alex2eva/autonomous-rc-car/autonomous-rc-car.docx

МИНИСТЕРСТКО ЦИФРОВОГО РАЗВИТИЯ СВЯЗИ И МАССОВЫХ

КОММУНИКАЦИЙ РОССИЙСКОЙ ФЕДЕРАЦИИ

Ордена трудового красного знамени федеральное государственное бюджетное

образовательное учреждение высшего образования

«Московский технический университет связи и информатики»

Факультет «Кибернетики и информационной безопасности»

Кафедра «Интеллектуальные системы в управлении и автоматизации»

КУРСОВАЯ РАБОТА

По дисциплине «Киберфизические системы и интернет вещей»

на тему «Создание прототипа движущегося робота, управляемого с помощью фоточувствительных элементов»

Выполнил:

студент 1 курса

группы БУТ2301

Алексеева Екатерина Вячеславовна

Приняла:

д.ф.-м.н., проф. Воронова Л. И.

Москва 2024

Введение

Развитие робототехники в последние десятилетия приобретает все более стремительный характер. Роботы все чаще применяются в различных сферах человеческой деятельности: от промышленного производства до оказания помощи в быту. Одним из ключевых направлений развития робототехники является создание автономных роботов, способных к самостоятельному передвижению и выполнению задач в сложных и динамичных средах.

Автономные движущиеся платформы востребованы в таких областях как: складская логистика, доставка товаров и грузов, транспорт, выполнение работ в труднодоступных местах и агрессивных средах и многих других.

Важное значение при создании автономных движущихся платформ имеют алгоритмы управления, обеспечивающие способность устройств эффективно и безопасно двигаться по требуемым маршрутам, а также их надежность и расширяемость.

В рамках данного проекта будет разработан функциональный прототип робота-машины, управляемого с помощью фоточувствительных элементов, демонстрирующий возможность автономного передвижения, основанного на обработке визуальной информации.

В ходе работы над проектом должны быть выполнены следующие задачи:

1. Провести анализ современных технологий и алгоритмов управления движущимися устройствами.
2. Определить набор функциональных требований к прототипу.
3. Выполнить проектирование аппаратной части прототипа, провести подбор элементной базы, реализовать размещение и подключение элементов.
4. Разработать программное обеспечение для реализации алгоритмов управления прототипом.
5. Провести испытания прототипа на предмет соответствия предъявляемым требованиям.

## 1. Анализ современных технологий и алгоритмов управления устройствами

По принципу управления автономные движущиеся платформы разделяют на полностью автономные и дистанционно управляемые. К первому типу относят системы, которые определяют параметры движения (направление, скорость) без внешних управляющих сигналов. Параметры движения систем второго типа корректируются с помощью внешних управляющих сигналов. Для ряда задач используют движущиеся платформы комбинированного типа.

Независимо от наличия или отсутствия внешних управляющих сигналов, движения систем по заданному маршруту обеспечивается реализованными в блоке управления системы алгоритмами. На рисунке «Рисунок 1» изображен пример движущегося устройства - Робот мобильного видеонаблюдения и охраны «Трал Патруль 4.0» [1].

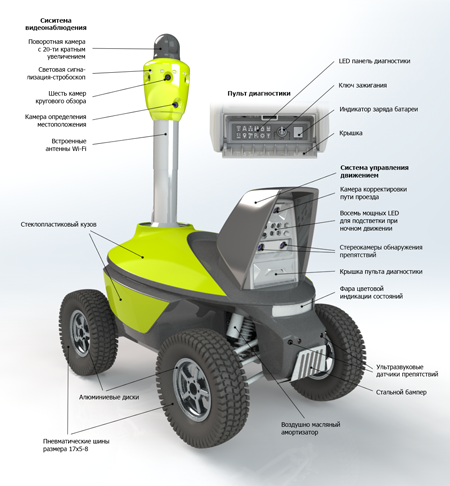
[picture p1: figure]

Рисунок 1 - Робот мобильного видеонаблюдения и охраны «Трал Патруль 4.0»

## 1.1 Технологии и механизмы управления движущимися устройствами

Для обеспечения движения полностью автономной платформы по заданному маршруту могут использоваться следующие технологии:

- Визуальное управление, на базе систем технического зрения [2].
- Управление на базе системы геопозиционирования [3].
- Следование заложенной в память устройства карте маршрута.

Для определения всех или отдельных параметров движения системы, управляемой с помощью внешних сигналов, возможны следующие способы:

- Передача управляющих сигналов посредством радиоканала, через сетевую инфраструктуру (мобильные сети, Wi-Fi и др.), проводное управление [4].
- Прокладывание трассы для передвижения (рельсы, магнитная лента).
- Следование за лидером.

Также для обеспечения заданных параметров движения применяются следующие датчики [5]:

- Ультразвуковые датчики расстояния.
- Датчики пространственного положения.
- Датчики скорости и ускорения.
- Фоточувствительные элементы.

## 1.2 Определяющие факторы при выборе способов управления

При проектировании автономной движущейся системы выбор способов управления необходимо осуществлять исходя из предъявляемых требований и стоимости реализации. В частности, нужно принимать во внимание следующие аспекты:

- Вариативность маршрутов.
- Динамичность изменения окружения.
- Технические ограничения возможности передачи управляющих сигналов.
- Требуемая точность соблюдения заданных параметров движения.

## 1.3 Постановка функциональных требований

В рамках проекта необходимо спроектировать и реализовать прототип движущегося робота, отвечающий следующим требованиям:

- Работа алгоритма робота должна начинаться и прекращаться по команде с ИК пульта управления.
- Направление движения робота должно определяться величиной светового потока на двух фоторезисторах.
- Должен быть реализован механизм предотвращения столкновения с препятствиями.

## Выводы

В данном разделе проанализированы современные технологии и алгоритмы управления движущимися устройствами, сформулированы требования к разрабатываемому в рамках проекта прототипа.

## 2. Разработка аппаратной части, проектирование

## 2.1 Архитектура и принцип работы разрабатываемого макета

В рамках проекта для управления самодвижущейся платформой использованы следующие способы управления (табл. 1):

Таблица 1 – Возможные способы управления платформой

Параметр движения | Тип управления | Механизм управления
Задание направления движения | Внешний сигнал | Фоточувствительные элементы
Задание скорости движения | Не осуществляется
Предотвращение столкновений | Внутренний датчик | Ультразвуковой датчик расстояния
Включение и выключение питания | Внешний сигнал | Инфракрасный пульт управления

На рисунке «Рисунок 2» изображена схема собранного прототипа.

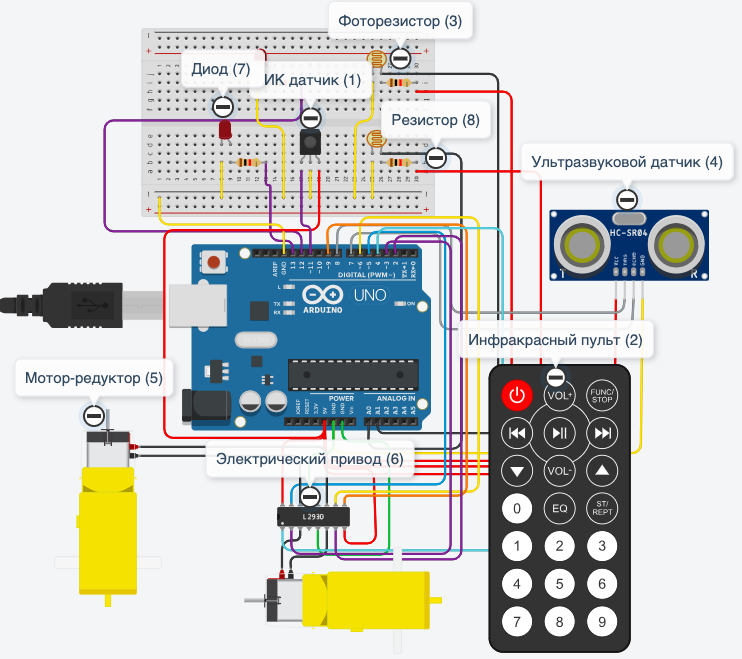
[picture p2: figure]

Рисунок 2 – Схема прототипа

## 2.2 Элементная база

Для реализации прототипа используется платформа Arduino Uno R3 (Рисунок 3).

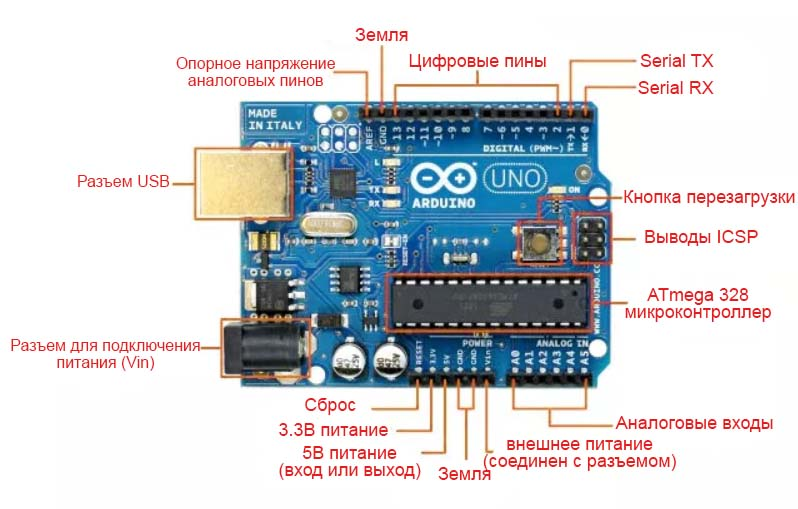
[picture p3: figure]
Arduino Uno R3. Распиновка, питание и подключение

Рисунок 3 - Расположение основных элементов на плате Arduino UNO R3

Для включения и выключения робота используется инфракрасный пульт управления (2) и ИК-датчик (1) [6].

Управление направлением движения робота осуществляется с помощью двух фоточувствительных элементов (ФЧЭ) следующим образом: в случае отсутствия светового потока на обоих ФЧЭ – робот не двигается, в случае наличия одинакового светового потока на обоих ФЧЭ – робот движется в прямом направлении, в случае если световой поток на одном из ФЧЭ интенсивнее - робот осуществляет поворот в сторону данного ФЧЭ. В качестве фоточувствительных элементов используется фоторезисторы MLG5516 (3) [7].

Для предотвращения столкновений используется ультразвуковой датчик HS-SR04 (4) (Рисунок 4) [8]. При достижении настраиваемой дистанции до препятствия робот останавливается.

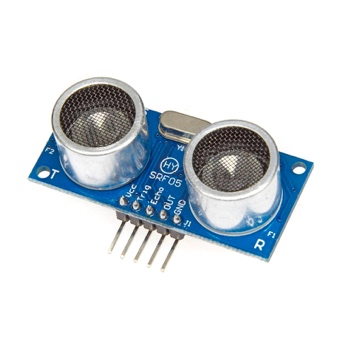
[picture p4: figure]
HY-SRF05 - купить в Москве ультразвуковой дальномер для Arduino с доставкой по России и СНГ

Рисунок 4 - Ультразвуковой датчик HS-SR04

Для передвижения используются 4 мотора-редуктора (5) [9], соединенные с колесами. Моторы редукторы подключаются через модуль управления двигателем L298N (Рисунок 5 и Рисунок 6) [10]. Изменение направления движения осуществляется путем обеспечения разницы скоростей вращения двигателей на левой и правой сторонах робота.

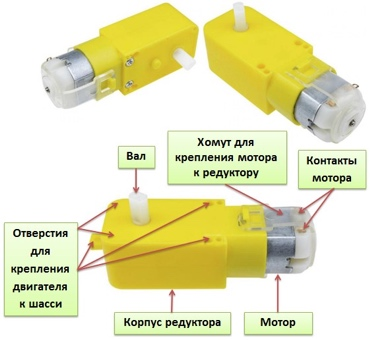
[picture p5: figure]
Мотор-редуктор 1:48
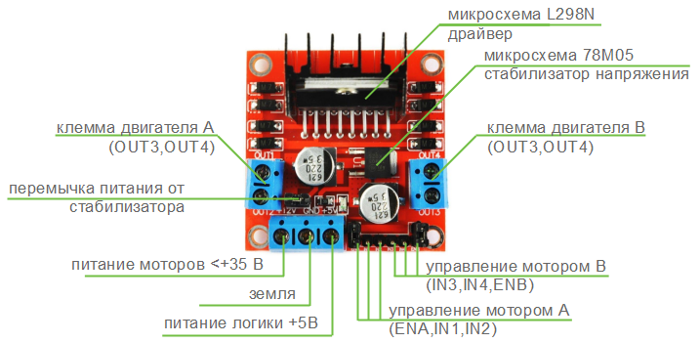
[picture p6: figure]
Драйвер мотора L298N элементы

Рисунок 5 - Мотор постоянного тока с редуктором | Рисунок 6 - Драйвер L298N для мотора постоянного тока

Для возможности осуществления визуального контроля за работой алгоритма робота используются два светодиода – индикатора направления движения (7).

Ниже приведена таблица элементов, необходимых для создания робота (табл. 2).

Таблица 2 – Перечень оборудования, необходимого для создания модели

№ п/п | Наименование оборудования | Цена, руб. | Кол-во, шт. | Сумма, руб.
1. | Плата Arduino UNO R3 | 890 | 1 | 890
2. | Макетная плата 830 точек | 160 | 1 | 160
3. | Соединительные провода | 2,5 | 31 | 77,5
4. | Светодиод | 12 | 2 | 24
5. | Резистор 220 Ом | 3 | 4 | 12
6. | Фоторезистор MLG5516 | 16 | 2 | 32
7. | ИК датчик VS1838B | 50 | 1 | 50
8. | Инфракрасный пульт | 189 | 1 | 189
9. | Ультразвуковой датчик HS-SR04 | 160 | 1 | 160
10. | Мотор-редуктор | 216 | 4 | 864
11. | Модуль управления двигателем L298N | 227 | 1 | 227
12. | Батареи | 39 | 3 | 117
13. | Батарейный отсек | 150 | 1 | 150
14. | Шасси | 325 | 2 | 650
15. | Колесо | 108 | 4 | 432
| ИТОГО | | | 4034

## 2.3 Сборка прототипа

Подключаем ИК датчик: левую ножку подключаем к цифровому выходу Arduino, правую – к питанию (5V), среднюю – к земле (GND).

Фоторезисторы подключаем через резисторы (8). Одной ножкой фоторезистор соединяется с землей (GND), другая подключается к выходу АЦП платы (аналого-цифровой преобразователь), к этой же ножке подключаем резистор 220 Ом.

Затем подключаем ультразвуковой датчик HS-SR04: контакт земли подключаем к выводу GND на плате Arduino, выход питания соединяем с 5V, выходы Trig и Echo подсоединяем к Arduino на цифровые выходы.

Светодиоды подключаем через резисторы. Короткой ножкой диод соединяется с землей (GND), другая подключается к цифровому выходу, к этой же ножке подключаем резистор 220 Ом.

Моторы-редукторы размещаются на шасси прототипа и подключаются к модулю управления двигателями L298N следующим образом:

- Контакты питания моторов подключаются к соответствующим выходам модуля управления (1 и 2 для левого, 3 и 4 для правого);
- Управляющие входы модуля управления (включение 1 и 2, включение 3 и 4) подключаются к цифровым выходам платы Arduino;
- Выходы питания модуля управления подключаются к 5V, выходы GND – к земле.

На схеме приведены два мотора-редуктора – этого достаточно для обеспечения принципиальной работоспособности схемы и алгоритмов.

Блок питания прототипа представлен тремя батареями 9V. Две из них, соединенные последовательно, питают модуль управления двигателями и через него - моторы-редукторы. Третья батарея питает плату Arduino.

## Выводы

В ходе данного раздела спроектирована монтажная схема, определены необходимые элементы и примерная стоимость модели, собран макет робота согласно монтажной схеме (Рисунок 7).

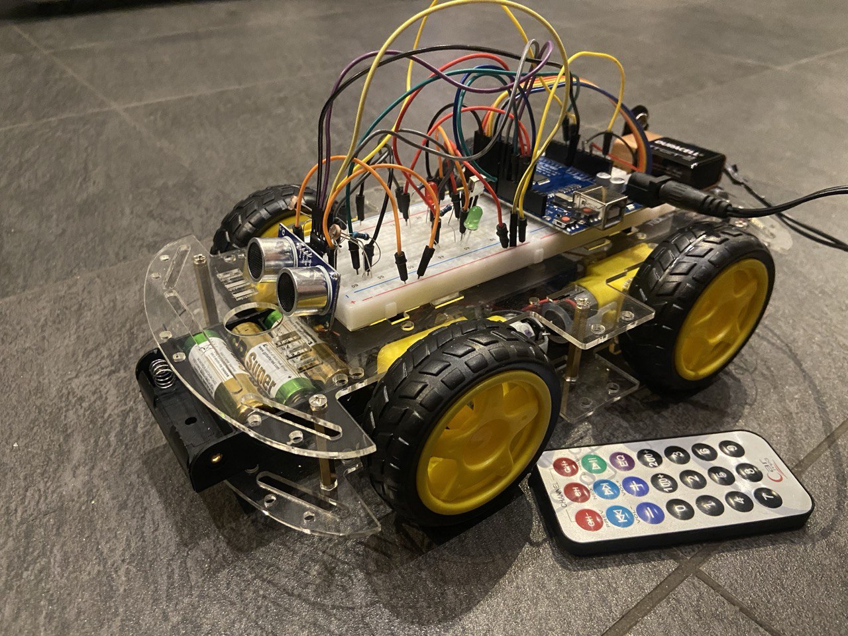
[picture p7: figure]

Рисунок 7 – Макет робота

## 3. Разработка программного обеспечения

## 3.1 Алгоритм управления прототипом

На рисунке «Рисунок 8» ниже представлен алгоритм управления прототипом.

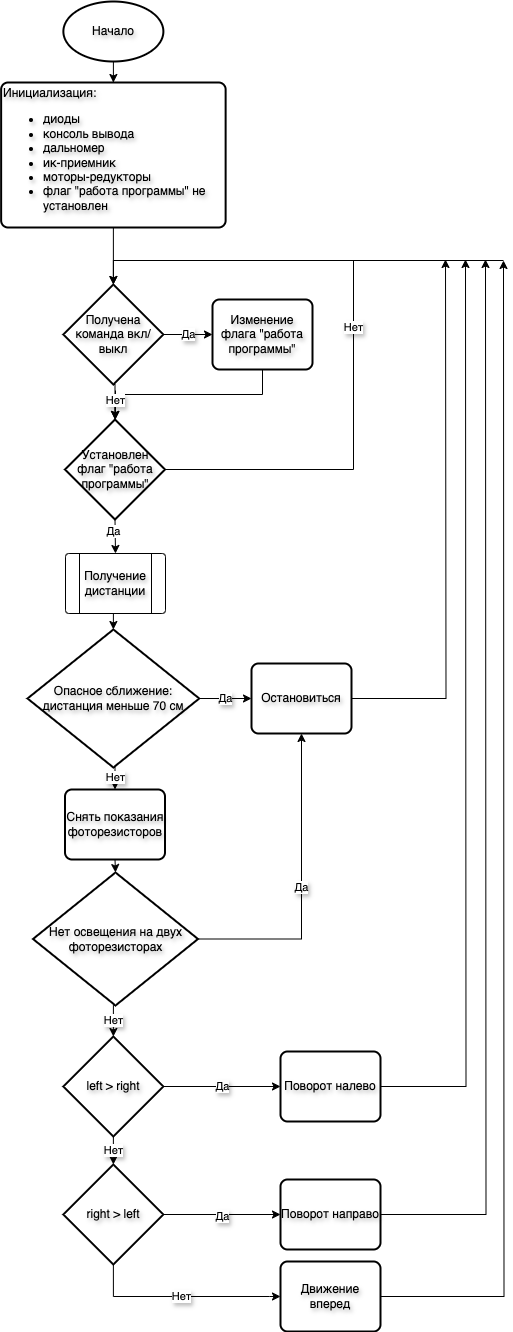
[picture p8: figure]

Рисунок 8 – Блок-схема алгоритма

## 3.2 Реализация программного обеспечения

Листинг 1 – подключение библиотек и определение констант и глобальных переменных, используемых в коде программы

В данном разделе производится инициализация переменных и определение констант. Детальная информация приведена в комментариях в коде.

//подключение библиотек

#include <IRremote.h>

//определение констант

//диоды

#define LED_LEFT 12

#define LED_RIGHT 13

//фоторезисторы

#define PS_LEFT A1

#define PS_RIGHT A0

#define PS_MAX 1017 // минимальное показание фоторезистора, означающее темноту

#define PS_MIN 350 // максимальное показание фоторезистора, означающее максимальную освещенность

#define PS_SENS 10 // минимальная разница между показаниями фоторезисторов для настройки чувствительности системы

//дальномер

#define PIN_TRIG 8

#define PIN_ECHO 7

#define DIST_MIN 70 // дистанция опасного сближения

//левый мотор

#define ENAL 9

#define IN3 6

#define IN4 5

//правый мотор

#define ENAR 4

#define IN1 3

#define IN2 2

//скорость

#define SPEED 150 //скорость вращения моторов-редукторов

//ИК-датчик

#define IR 11

#define IR_PWR 0xFF00BF00 // код кнопки пульта управления

//ИК-датчик

IRrecv irrecv(IR); // создание объекта для работы с пультом

//флаг "работа программы"

bool isRunning = false; // переменная, отражающая состояние работы алгоритма (работает/не работает)

Листинг 2 – инициализация элементов

Данная функция используется для инициализации компонентов схемы до начала работы алгоритма. Здесь и далее в коде используются следующие функции (табл. 3).

Таблица 3 – Перечень используемых функций

pinMode | Конфигурирует режим работы указанного вывода: как вход либо как выход
digitalWrite | Отправляет на цифровой вывод значение HIGH или LOW
delayMicroseconds, delay | Приостанавливает выполнение программы на указанный промежуток времени (в микро и миллисекундах)
pulseIn | Считывает длительность импульса на выводе
analogWrite | Формирует заданное аналоговое напряжение на выводе в виде ШИМ-сигнала.
Serial.print, Serial.println | Отправляет данные в последовательный порт

void setup()

{

//инициализация компонентов

//диоды

pinMode(LED_LEFT, OUTPUT); // задаем пин как выход

pinMode(LED_RIGHT, OUTPUT);

//консоль вывода

Serial.begin(9600); // установка соединения на скорости 9600 бит/сек

//дальномер

pinMode(PIN_TRIG, OUTPUT);

pinMode(PIN_ECHO, INPUT); // задаем пин как вход

//левый мотор

pinMode(ENAL, OUTPUT);

pinMode(IN3, OUTPUT);

pinMode(IN4, OUTPUT);

//исходно моторы выключены

digitalWrite(IN3, LOW);

digitalWrite(IN4, LOW);

//правый мотор

pinMode(ENAR, OUTPUT);

pinMode(IN1, OUTPUT);

pinMode(IN2, OUTPUT);

digitalWrite(IN1, LOW);

digitalWrite(IN2, LOW);

//ИК-датчик - инициализация

irrecv.enableIRIn();

}

Листинг 3 – функция определения дистанции до препятствия

Ультразвуковой датчик расстояния HS-SR04 работает по принципу эхолокации — посылает пучок ультразвука и получает его отражение с некоторой задержкой, с помощью которой и можно высчитать расстояние до объекта. Диапазон дальности измерения составляет от 2 до 400 см.

Для получения данных с датчика необходимо:

- Подать на выход Trig импульс длительностью 10 микросекунд;
- Трансмиттер отправит 8 импульсов с частотой 40 кГц;
- Когда импульсы отразятся от препятствия и будут приняты ресивером, то на выходе Echo образуется входной сигнал;
- С помощью формулы длительность сигнала преобразуется в расстояние до препятствия.

//функция определения дистанции до препятствия

double getDistance()

{

digitalWrite(PIN_TRIG, LOW);

delayMicroseconds(5);

digitalWrite(PIN_TRIG, HIGH);

delayMicroseconds(10);

digitalWrite(PIN_TRIG, LOW);

return pulseIn(PIN_ECHO, HIGH)/58.2;

}

Листинг 4 – функции управления движения роботом

Управление моторами осуществляется через драйвер L298N. При этом через пины ENAL и ENAR задается скорость вращения левых и правых двигателей соответственно, сигналы на пинах IN1, IN2, IN3, IN4 определяют направление вращения. Для движения прямо левому и правому двигателям задается одинаковая скорость, для остановки – скорость равная нулю, для поворота направо – скорость левых двигателей ненулевая, правых – нулевая, для поворота налево – наоборот.

//функция остановки робота

void stop()

{

digitalWrite(LED_LEFT, LOW);

digitalWrite(LED_RIGHT, LOW);

analogWrite(ENAL, 0);

digitalWrite(IN3, HIGH);

digitalWrite(IN4, LOW);

analogWrite(ENAR, 0);

digitalWrite(IN1, HIGH);

digitalWrite(IN2, LOW);

}

//функция поворота налево

void moveLeft()

{

digitalWrite(LED_LEFT, HIGH);

digitalWrite(LED_RIGHT, LOW);

analogWrite(ENAL, 0);

digitalWrite(IN3, HIGH);

digitalWrite(IN4, LOW);

analogWrite(ENAR, SPEED);

digitalWrite(IN1, HIGH);

digitalWrite(IN2, LOW);

}

//функция поворота направо

void moveRight()

{

digitalWrite(LED_LEFT, LOW);

digitalWrite(LED_RIGHT, HIGH);

analogWrite(ENAL, SPEED);

digitalWrite(IN3, HIGH);

digitalWrite(IN4, LOW);

analogWrite(ENAR, 0);

digitalWrite(IN1, HIGH);

digitalWrite(IN2, LOW);

}

//функция движения вперед

void moveForward()

{

digitalWrite(LED_LEFT, HIGH);

digitalWrite(LED_RIGHT, HIGH);

analogWrite(ENAL, SPEED);

digitalWrite(IN3, HIGH);

digitalWrite(IN4, LOW);

analogWrite(ENAR, SPEED);

digitalWrite(IN1, HIGH);

digitalWrite(IN2, LOW);

}

Листинг 5 – обработка команд ИК пульта управления

Для возможности остановки и запуска алгоритма программа сохраняет текущее состояние работы алгоритма (работает/не работает) в глобальной переменной isRunning, а также при входе в функцию loop осуществляется проверка поступления команды вкл/выкл от пульта управления. Если команда вкл/выкл поступила текущее состояние работы алгоритма меняется на противоположенное. В зависимости от актуального состояния либо выполняется тело цикла, либо осуществляется остановка двигателей и выход из функции loop.

//основной цикл

void loop()

{

//проверка команды вкл/выкл

if (irrecv.decode())

{

//Serial.println(irrecv.decodedIRData.decodedRawData, HEX); // печатаем код кнопки

if (irrecv.decodedIRData.decodedRawData == IR_PWR)

{

isRunning = !isRunning;

Serial.print("power ");

Serial.println(isRunning);

}

irrecv.resume(); // принимаем следующую команду

}

//проверка флага "работа программы"

if (!isRunning)

{

stop();

return;

}

Листинг 6 - предотвращение столкновения с препятствием

Если дистанция до препятствия меньше заданного параметра “дистанция опасного сближения” – останавливаем двигатели и выходим из функции loop.

double distance = getDistance();

Serial.print("distance: ");

Serial.println(distance);

//опасное сближение

if (distance < DIST_MIN)

{

stop();

delay(100);

return;

}

Листинг 7 – определение направления движения

В данном разделе кода производится сравнение показаний фоторезисторов с учетом параметров, определяющих чувствительность системы. Одинаковая освещенность – движение вперед, отсутствие освещенности на двух фоторезисторах – остановка, освещенность на одном из фоторезисторов больше – поворот в сторону фоторезистора с меньшей освещенностью.

//снятие показаний фоторезисторов

int left = analogRead(PS_LEFT);

int right = analogRead(PS_RIGHT);

Serial.print("left: ");

Serial.println(left);

Serial.print("right: ");

Serial.println(right);

//нормирование показаний фоторезисторов

if (left < PS_MIN)

left = PS_MIN;

if (left > PS_MAX)

left = PS_MAX;

if (right < PS_MIN)

right = PS_MIN;

if (right > PS_MAX)

right = PS_MAX;

//определение направления движения

if ((right - left) >= PS_SENS)

moveLeft();

else if ((left - right) >= PS_SENS)

moveRight();

else if (right < PS_MAX)

moveForward();

else

stop();

delay(100);

}

## 3.3 Тестирование работы робота

Тестирование прототипа осуществляется путем проведения ходовых испытаний робота в двух режимах:

1. Робот подключен к ноутбуку. Испытания проводятся с одновременным мониторингом принимаемых управляющих сигналов, показаний датчиков и корректности работы алгоритмов управления через среду отладки.
2. Робот движется в автономном режиме, питание осуществляется от встроенного источника питания.

В ходе испытаний осуществляется проверка соответствия поведения робота предъявляемым требованиям в штатном и пограничном режимах.

Выявленные в ходе тестирования проблемы:

1. При подаче питания на плату Arduino через разъем 5v напряжение было недостаточным для модуля управления двигателями L298N, при этом при подаче питания через usb-порт напряжение было достаточным. Решение проблемы: питание на плату Arduino подано через внешний разъем подачи питания от батарейки 9v.
2. По результатам испытаний потребовалась настройка параметров системы предотвращения столкновений – увеличена минимальная допустимая дистанция до препятствия.

## Заключение

В ходе выполнения проекта спроектирован и разработан прототип движущегося робота, управляемого с помощью фоточувствительных элементов. Ниже приведены изображения работающего макета (Рисунок 9), (Рисунок 10).

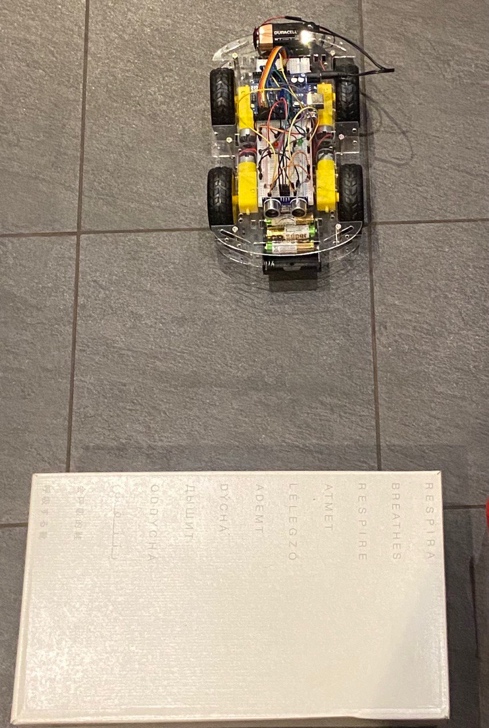
[picture p9: figure]
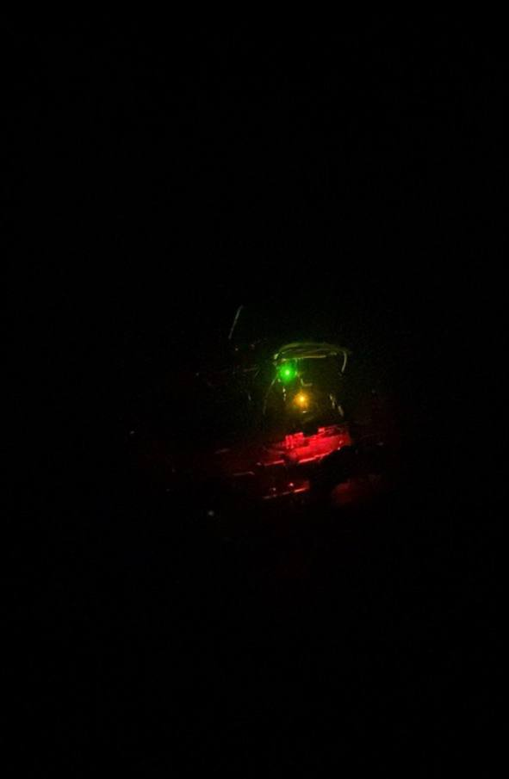
[picture p10: figure]

Рисунок 9 - Остановка перед препятствием | Рисунок 10 - Остановка при отсутствии освещения

В ходе тестовых испытаний подтверждена правильность выбора элементной базы, корректность разработанных алгоритмов управления.

Спроектированное решение может являться базой для построения более сложных автономных самодвижущихся устройств за счет расширяемости аппаратной платформы и гибкости реализованных алгоритмов управления.

## Список использованной литературы

1. Робот мобильного видеонаблюдения и охраны «Трал Патруль 4.0» URL: https://www.smprobotics.ru/robot-mobilnogo-videonablyudeniya-tral-patrul/ (Дата обращения: 21.05.2024)
2. ВИЗУАЛЬНОЕ УПРАВЛЕНИЕ ДВИЖЕНИЕМ РОБОТОВ URL: https://rusrobotics.ru/index.php/nomer-4-5-2014/29-obshchie-voprosy/77-vizualnoe-upravlenie-dvizheniem-robotov (Дата обращения: 20.05.2024)
3. Популярные технологии для определения местоположения объектов URL: https://nvgn.ru/blog/populyarnyie-texnologii-dlya-opredeleniya-mestopolozheniya/ (Дата обращения: 20.05.2024)
4. Подходы к классификации беспроводных технологий URL: https://sdo.nsuem.ru/mod/book/tool/print/index.php?id=8131 (Дата обращения: 19.05.2024)
5. Типы датчиков в робототехнике URL: https://www.evsint.com/ru/types-of-sensors-in-robotics/ (Дата обращения: 21.05.2024)
6. ИК пульт ардуино // URL: https://arduinomaster.ru/datchiki-arduino/ir-ik-pult-upravleniya-arduino/ (Дата обращения: 15.05.2024).
7. Подключение фоторезистора к ардуино и работа с датчиком освещенности // URL: https://arduinomaster.ru/datchiki-arduino/photorezistor-arduino-datchik-sveta/ (Дата обращения: 13.05.2024).
8. Ультразвуковой датчик расстояния Ардуино HC-SR04 URL: https://arduinomaster.ru/datchiki-arduino/ultrazvukovoj-dalnomer-hc-sr04/ (Дата обращения: 17.05.2024)
9. Как подключить моторчик к Ардуино URL: https://xn--18-6kcdusowgbt1a4b.xn-p1ai/%D0%BF%D0%BE%D0%B4%D0%BA%D0%BB%D1%8E%D1%87%D0%B5%D0%BD%D0%B8%D0%B5-%D0%BC%D0%BE%D1%82%D0%BE%D1%80%D0%B0-%D0%B0%D1%80%D0%B4%D1%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 (Дата обращения: 18.05.2024)
10. Ардуино: драйвер L298N для мотора постоянного тока URL: https://robotclass.ru/tutorials/arduino-l298-dc-motor-driver/ (Дата обращения: 18.05.2024)
